soricesg/ece387-infinity-mirror/wiki/images/IMG_0479.jpg

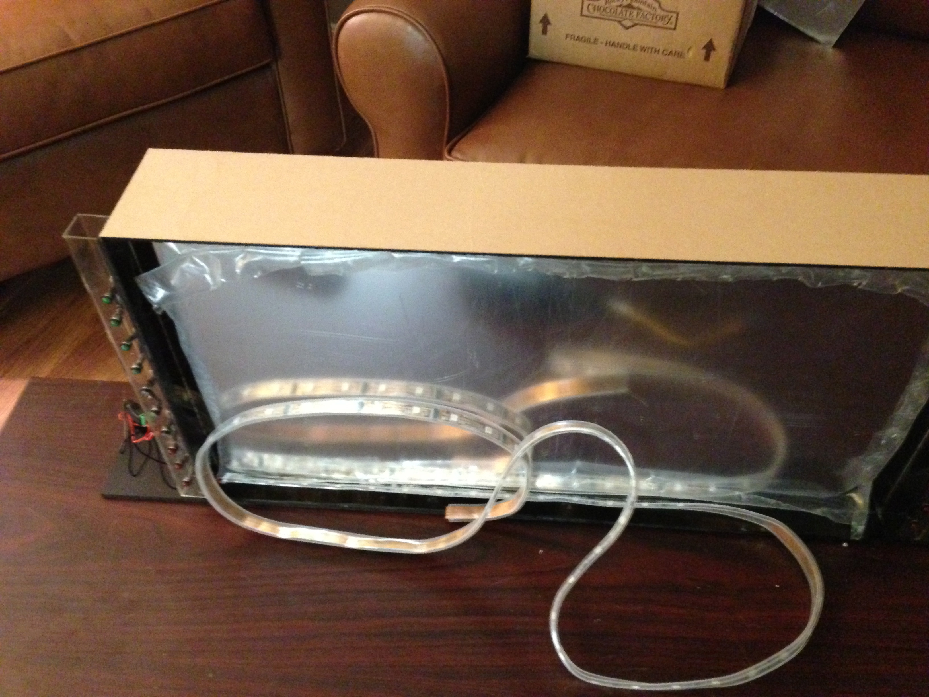
wiki/images/IMG_0479.jpg
