soricesg/ece387-infinity-mirror/wiki/PartsList.wiki

#summary A list of all the parts I used, along with prices and where I purchased them

Here is a list of all the parts I used, along with where I sourced them from and the price at the time I purchased them. Everything I purchased was based on the size of my project, if you intend to build this yourself, make sure you order your parts based on how big you want the final product to be. All listed costs are from time of purchase, not including tax or shipping. 

=Parts List=
*Enclosure*
 * Black acrylic sheet 1/4"x4"x32" -- for the base 
  * Source -- tapplastics.com
  * Cost -- $12.22
 * Black acrylic sheet 1/8"x4"x52" -- for the sides/top 
  * Source -- tapplastics.com
  * Cost -- $10.33
 * Mirrored acrylic sheet 1/8"x12"x23-3/4" -- rear panel mirror
  * Source -- tapplastics.com
  * Cost -- $17.50
 * Mirrored acrylic two-way 1/8"x12-3/8"x24" -- front panel mirror 
  * Source -- tapplastics.com
  * Cost --$34.60
 * Square acrylic tubing 1"x1"x12' -- structural supports
  * Source -- tapplastics.com
  * Cost -- $17.90

*Electronics*
 * Digital RGB LED strip -- 2 meters
  * Source -- Adafruit
  * Cost -- $59.50
 * Power supply for led strip -- 5v 10A
  * Source -- Adafruit
  * Cost -- $25.00
 * Female DC adapter
  * Source -- Adafruit
  * Cost -- $2.00
 * Ping Ultrasonic distance sensor
  * Source -- Parallax
  * Cost -- $29.99
 * 2 Toggle switches to control mode
  * Source -- Radioshack
  * Cost -- <$5
 * VU Meter to display audio
  * Source -- VUmeter.com
  * Cost -- $34.20
 * 3.5mm splitter
  * Source -- Radioshack
  * Cost -- <$5
 * Speakers
  * Source -- ?
  * Cost -- ?
 * Molex power supply for VU meter
  * Source -- ebay  
  * Cost -- <$7
 * Arduino Uno R3
  * Source -- sparkfun
  * Cost --$30.00
 *

*Tools*
 * Acrylic Cement 1 pint -- hold all the acrylic together
  * Source -- tapplastics.com
  * Cost -- $12.65
 * 16 Gauge Hypo applicator -- apply the acrylic cement 
  * Source -- tapplastics.com
  * Cost -- $3.50
 * Soldering iron
 * Solder
 * Various wires, wire cutters/wire strippers
 * etc.
