soricesg/ece387-infinity-mirror/(commit log)

2013-04-25 Edited wiki page Assembly through web user interface.
2013-05-07 Completed the description on how to assembly everything, just need to add in some images.
